DiamondKeySecurity/sensor_hw/PCA-000152-02.xls

Digital Design Corporation
Diamond Key Mezz Rev 2
PCA-000152-02
Nov 07 2018 10:00:46
DDC Part # | Quantity | Designator | Description | Value | Package | Supplier | Supplier Part # | MFG | MFG Part # | RoHS/WEEE
CAP-000013-00 | 1 | C5 | CAP CERM .047UF 10% 16V X5R 0402 Mfg. AVX Corporation | 0.047uF | 0402 | Avnet Electronics | 0402YD473KAT2A | AVX Corporation | 0402YD473KAT2A | Compliant 6 of 6
CAP-000169-00 | 8 | C1, C2, C3, C7, C8, C9, C10, C11 | .1uF, 25V, X5R, 0402, Mfg: Taiyo Yuden | 0.1uF | 0402 | Avnet Electronics | TMK105BJ104KV-F/BKN | Taiyo Yuden | TMK105BJ104KV-F | Compliant 6 of 6
CAP-000192-00 | 1 | C6 | .068uF, 16V, X5R, 0402 | .068uF | 0402 | Digi-Key Corporation | 445-4968-6-ND | TDK | C1005X5R1C683K | Compliant 6 of 6
CON-000108-00 | 1 | J3 | 2 PIN, 1 ROW, .1 INCH, Mfg: Samtec. | TSW-102 |  | Arrow Electronics (Advantage) | TSW-102-07-F-S | Samtec | TSW-102-07-F-S | Compliant 6 of 6
CON-000176-00 | 1 | J4 | CONN HEADER 2POS .100 R/A GOLD, Mfg: Molex | 70553-0001 |  | Digi-Key Corporation | WM4900-ND | Molex | 70553-0001 | Compliant 6 of 6
CON-000369-00 | 1 | REP_JP3 | CONN HEADER 6POS .100 STR TIN | 67996-406HLF | N/A | Digi-Key Corporation | 609-3218-ND | FCI | 67996-406HLF | Lead free / RoHS Com
CON-000533-00 | 1 | J2 | HOLDER BATT 1 CELL CR123A | CR123A |  | Digi-Key Corporation | 708-1412-ND | Bulgin | BX0123 | Lead free / RoHS Com
CON-000534-00 | 1 | JP5 | CONN RCPT 10POS .100 | 10_Pin |  | Digi-Key Corporation | 609-3550-ND | AmphenolFCI | 75915-310LF | Lead free / RoHS Com
CON-000536-00 | 2 | SV1, SV3 | CONN RCPT 16POS .100 2 Row | 8x2_Socket |  | Digi-Key Corporation | 609-3554-ND | AmphenolFCI | 87606-308LF | Lead free / RoHS Com
CON-000537-00 | 1 | JP3 | CONN RCPT .100 2x3 | 2x3_Socket |  | Digi-Key Corporation | SAM10016-ND | SamtecInc. | SSW-103-01-F-D | Lead free / RoHS Com
CON-000539-00 | 1 | J1 | CONN RCPT 6POS .100 TH | 6 Pin Socket |  | Digi-Key Corporation | 609-3558-ND | AmphenolFCI | 75915-306LF | Lead free / RoHS Com
CON-000540-00 | 1 | REP_J1 | CONN HEADER 6 POS 2.54 TH | 6 Pin Header |  | Digi-Key Corporation | 732-5319-ND | WurthElectronicsInc. | 61300611121 | Lead free / RoHS Com
CON-000545-00 | 1 | REP_JP5 | CONN HEADER 10POS .100 STR 30AU | 10 Pin Header |  | Digi-Key Corporation | 609-3250-ND | AmphenolFCI | 68000-110HLF | Lead free / RoHS Com
CON-000550-00 | 1 | J5 | Connector Header Through Hole, Right Angle 7 position 0.100" (2.54mm) | 705530006 | 7 pin | Digi-Key Corporation | WM4905-ND | Molex | 705530006 | Lead free / RoHS Com
DIO-000075-00 | 1 | PD1 | PHOTODIODE PIN 900NM 0805 | TEMD7000X01 | 0805 | Digi-Key Corporation | TEMD7000X01DKR-ND | VishaySemiconductorO | TEMD7000X01 | Lead free / RoHS Com
DIO-000077-00 | 1 | D4 | Diode Standard 30V 15A Surface Mount DDPAK/TO-263-3 26mV Vf | SM74611 | TO-263 | Digi-Key Corporation | 296-35688-1-ND | Texas Instruments | SM74611KTTR | Lead free / RoHS Com
ICT-000256-00 | 1 | U2 | PHOTOCOUPLER, TRANSISTOR OUT | PS2711 | SOP-4 | Digi-Key Corporation | PS2711-1-M-A-ND | NEC | PS2711-1-M-A | Compliant 6 of 6
ICT-000794-00 | 1 | U3 | ACCELEROMETER 2-8G SPI 16LGA | ADXL362 | 16-TFLGA | Digi-Key Corporation | ADXL362BCCZ-RLTR-ND | AnalogDevicesInc. | ADXL362BCCZ-RL | Lead free / RoHS Com
ICT-000795-00 | 1 | U4 | IC SUPERVISOR MPU 16SOIC | ADM696 | 16-SOIC | Digi-Key Corporation | ADM696ARZ-REELTR-ND | AnalogDevicesInc. | ADM696ARZ-REEL | Lead free / RoHS Com
ICT-000798-00 | 1 | U9 | IC OPTICAL PROXIMITY 24QFN | AmbLtSensor | QFN24 | Digi-Key Corporation | MLX75030RLQ-AAA-000-RETR-ND | MelexisTechnologiesN | MLX75030RLQ-AAA-000-RE | Lead free / RoHS Com
ICT-000799-00 | 1 | U5 | IC I/O EXPANDER SPI 16B 28SOIC | 16bitSPIExpander | 28-SOIC | Digi-Key Corporation | MCP23S17T-E/SOTR-ND | MicrochipTechnology | MCP23S17T-E/SO | Lead free / RoHS Com
ICT-000807-00 | 1 | U1 | SCHMITT TRIGGER PHOTOCOUPLER | H11L1S | 6 pin | Digi-Key Corporation | 1080-1201-1-ND | Everlight | H11L1S(TA) | Lead free / RoHS Com
LED-001001-00 | 3 | D1, D2, D3 | LED, Green, 0603, Mfg: Avago | HSMG-C190 | 0603 | Arrow Electronics (Advantage) | HSMG-C190**MULT1 | Avago | HSMG-C190 | Compliant 6 of 6
MOD-000049-00 | 1 | U6 | Isolated Module DC DC Converter 1 Output 3.3V 227mA 2.97V - 3.63V Input | CME0303S3C | 4 pin | Digi-Key Corporation | 811-2889-5-ND | Murata | CME0303S3C | Lead free / RoHS Com
PCB-000270-02 PCB | 1 | PCB1 | Diamond Key Mezz Rev 2 |  |  | PCB Universe | PCB-000270-02 | PCB Universe | PCB-000270-02
RES-000002-00 | 1 | R17 | 0 OHM 1/16W 5% 0402, Mfg: Panasonic | 0 | 0402 | Digi-Key Corporation | P0.0JCT-ND | Panasonic | ERJ-2GE0R00X | Compliant 6 of 6
RES-000004-00 | 4 | R4, R5, R6, R9 | 1K 0402 1% 1/10W, Mfg: Panasonic | 1K | 0402 | Avnet Electronics | ERJ-2RKF1001X/BKN | Panasonic | ERJ-2RKF1001X | Compliant 6 of 6
RES-000005-00 | 4 | R1, R7, R13, R14 | RES 4.75K OHM 1/10W 1% 0402 SMD, MFG: PANASONIC | 4.75K | 0402 | Avnet Electronics | ERJ-2RKF4751X/BKN | Panasonic | ERJ-2RKF4751X | Compliant 6 of 6
RES-000006-00 | 1 | R2 | 100 Ohms 0402 1% 1/10W, Mfg: Panasonic | 100 | 0402 | Avnet Electronics | ERJ-2RKF1000X | Panasonic | ERJ-2RKF1000X | Compliant 6 of 6
RES-000007-00 | 2 | R18, R19 | 10K 0402 1% 1/10W, Mfg: Panasonic | 10K | 0402 | Avnet Electronics | ERJ-2RKF1002X/BKN | Panasonic | ERJ-2RKF1002X | Compliant 6 of 6
RES-000014-00 | 1 | R3 | 75 0402 1% 1/10W Mfg. Panasonic | 75 | 0402 | Digi-Key Corporation | P75.0LDKR-ND | Panasonic | ERJ-2RKF75R0X | Compliant 6 of 6
RES-000021-00 | 3 | R8, R10, R12 | RES 100K OHM 1/10W 1% 0402 SMD Mfg. Panasonic | 100K | 0402 | Avnet Electronics | ERJ-2RKF1003X | Panasonic | ERJ-2RKF1003X | Compliant 6 of 6
RES-000124-00 | 1 | R11 | 1.5K 0402 1% 1/16W | 1.5K | 0402 | Digi-Key Corporation | P1.50KLTR-ND | Panasonic | ERJ-2RKF1501X | Compliant 6 of 6
RES-000437-00 | 1 | R15 | 56.2K 0402 1% 1/16W | 56.2K | 0402 | Digi-Key Corporation | P56.2KLDKR-ND | Panasonic | ERJ-2RKF5622X | Compliant 6 of 6
RLY-000003-00 | 2 | RLY1, RLY2 | RELAY 2 COIL LATCHING DPDT 1A 3V | 2 Coil |  | Digi-Key Corporation | 255-2347-2-ND | PanasonicElectricWor | TXS2SA-L2-3V-Z | Lead free / RoHS Com
XSR-000057-00 | 5 | Q1, Q2, Q3, Q4, Q5 | TRANS PREBIAS 470/10k NPN 200MW SOT23-3 | 470/10k | SOT-23 | Arrow Electronics (Advantage) | DDTD142JC-7-F**MULT1 | DiodesIncorporated | DDTD142JC-7-F | Lead free / RoHS Com
