DiamondKeySecurity/sensor_hw/Sensor.ods

Cryptech Sensor Board
> All the information Screaming Circuits needs in a Bill of Materials to complete an order is in columns B through G.
> Distributor part numbers (ie.. DigiKey Part #'s) are not required for Kitted orders, but are helpful for Turn-Key pricing.
> The BOM is the primary file that Screaming Circuits goes by whenever there is any conflicting information.
> There is information in the far right column that helps to get an assembly quote. Look at the bottom to see a board summary.
> Highlight in RED any Do Not Stuff parts ("DNS") , and they will be excluded from the build. Parts not listed on the BOM are considered DNS.
Item # | Qty | Ref Des | Manufacturer | Mfg Part # | Dist. Part # | Description | Package | Type
1 | 1 | C5 | AVX Corporation | 0402YD473KAT2A |  | CAP CERM .047UF 10% 16V X5R 0402 | 402 | smt | 0
2 | 8 | C1, C2, C3, C7, C8, C9, C10, C11 | Taiyo Yuden | TMK105BJ104KV-F |  | .1uF, 25V, X5R, 0402, Mfg: Taiyo Yuden | 402 |  | 0
3 | 1 | C6 | TDK | C1005X5R1C683K |  | .068uF, 16V, X5R, 0402 | 402 |  | 0
4 | 1 | J3 | Samtec | TSW-102-07-F-S |  | 2 PIN, 1 ROW, .1 INCH, Mfg: Samtec. |  | thru | 1 | 2
5 | 1 | J4 | Molex | 70553-0001 |  | CONN HEADER 2POS .100 R/A GOLD, Mfg: Molex |  | thru | 1 | 2
6 | 1 | REP_JP3 | FCI | 67996-406HLF |  | CONN HEADER 6POS .100 STR TIN | N/A | thru | 1 | 6
7 | 1 | J2 | Bulgin | BX0123 |  | HOLDER BATT 1 CELL CR123A |  | thru | 1 | 2
8 | 1 | JP5 | AmphenolFCI | 75915-310LF |  | CONN RCPT 10POS .100 |  | thru | 1 | 10
9 | 2 | SV1, SV3 | AmphenolFCI | 87606-308LF |  | CONN RCPT 16POS .100 2 Row |  | thru | 2 | 32
10 | 1 | JP3 | SamtecInc. | SSW-103-01-F-D |  | CONN RCPT .100 2x3 |  | thru | 1 | 6
11 | 1 | J1 | AmphenolFCI | 75915-306LF |  | CONN RCPT 6POS .100 TH |  | thru | 1 | 6
12 | 1 | REP_J1 | WurthElectronicsInc. |  |  | CONN HEADER 6 POS 2.54 TH |  | thru | 1 | 6
13 | 1 | REP_JP5 | AmphenolFCI | 68000-110HLF |  | CONN HEADER 10POS .100 STR 30AU |  | thru | 1 | 10
14 | 1 | J5 | Molex |  |  | Connector Header Thru Hole, Right Angle 7 position 0.100" (2.54mm) | 7 pin | thru | 1 | 7
15 | 1 | PD1 | VishaySemiconductorO | TEMD7000X01 |  | PHOTODIODE PIN 900NM 0805 | 805 | smt | 0
16 | 1 | D4 | Texas Instruments | SM74611KTTR |  | Diode Standard 30V 15A Surface Mount DDPAK/TO-263-3 26mV Vf | TO-263 | smt | 0
17 | 1 | U2 | NEC | PS2711-1-M-A |  | PHOTOCOUPLER, TRANSISTOR OUT | SOP-4 | smt | 0
18 | 1 | U3 | AnalogDevicesInc. | ADXL362BCCZ-RL |  | ACCELEROMETER 2-8G SPI 16LGA | 16-TFLGA |  | 0
19 | 1 | U4 | AnalogDevicesInc. | ADM696ARZ-REEL |  | IC SUPERVISOR MPU 16SOIC | 16-SOIC |  | 0
20 | 1 | U9 | MelexisTechnologiesN | MLX75030RLQ-AAA-000-RE |  | IC OPTICAL PROXIMITY 24QFN | QFN24 |  | 0
21 | 1 | U5 | MicrochipTechnology | MCP23S17T-E/SO |  | IC I/O EXPANDER SPI 16B 28SOIC | 28-SOIC |  | 0
22 | 1 | U1 | Everlight | H11L1S(TA) |  | SCHMITT TRIGGER PHOTOCOUPLER | 6 pin |  | 0
23 | 3 | D1, D2, D3 | Avago | HSMG-C190 |  | LED, Green, 0603, Mfg: Avago | 603 |  | 0
24 | 1 | U6 | Murata | CME0303S3C |  | Isolated Module DC DC Converter 1 Output 3.3V 227mA 2.97V - 3.63V Input | 4 pin | thru | 1 | 4
25 | 1 | PCB1 | PCB Universe | PCB-000270-02 |  | Diamond Key Mezz Rev 2 |  |  | 0
26 | 1 | R17 | Panasonic | ERJ-2GE0R00X |  | 0 OHM 1/16W 5% 0402, Mfg: Panasonic | 402 |  | 0
27 | 4 | R4, R5, R6, R9 | Panasonic | ERJ-2RKF1001X |  | 1K 0402 1% 1/10W, Mfg: Panasonic | 402 |  | 0
28 | 4 | R1, R7, R13, R14 | Panasonic | ERJ-2RKF4751X |  | RES 4.75K OHM 1/10W 1% 0402 SSMD | 402 |  | 0
29 | 1 | R2 | Panasonic | ERJ-2RKF1000X |  | 100 Ohms 0402 1% 1/10W, Mfg: Panasonic | 402 |  | 0
30 | 2 | R18, R19 | Panasonic | ERJ-2RKF1002X |  | 10K 0402 1% 1/10W, Mfg: Panasonic | 402 |  | 0
31 | 1 | R3 | Panasonic | ERJ-2RKF75R0X |  | 75 0402 1% 1/10W Mfg. Panasonic | 402 |  | 0
32 | 3 | R8, R10, R12 | Panasonic | ERJ-2RKF1003X |  | RES 100K OHM 1/10W 1% 0402 SMD Mfg. Panasonic | 402 |  | 0
33 | 1 | R11 | Panasonic | ERJ-2RKF1501X |  | 1.5K 0402 1% 1/16W | 402 |  | 0
34 | 1 | R15 | Panasonic | ERJ-2RKF5622X |  | 56.2K 0402 1% 1/16W | 402 |  | 0
35 | 2 | RLY1, RLY2 | PanasonicElectricWor | TXS2SA-L2-3V-Z |  | RELAY 2 COIL LATCHING DPDT 1A 3V |  | thru | 2 | 8
36 | 5 | Q1, Q2, Q3, Q4, Q5 | DiodesIncorporated | DDTD142JC-7-F |  | TRANS PREBIAS 470/10k NPN 200MW SOT23-3 | SOT-23 |  | 0
 | 60 |  |  |  |  |  |  |  | 15 | 101
 |  |  |  |  |  | BOARD SUMMARY FOR QUOTE
 |  |  |  |  |  | Unique Part Count | 36
 |  |  |  |  |  | Total Placements | 60
 |  |  |  |  |  | Thru Hole Placements | 15
 |  |  |  |  |  | Has BGA Placements? | No
