DiamondKeySecurity/sensor_hw/PCA-000152-01_Assembly.PDF

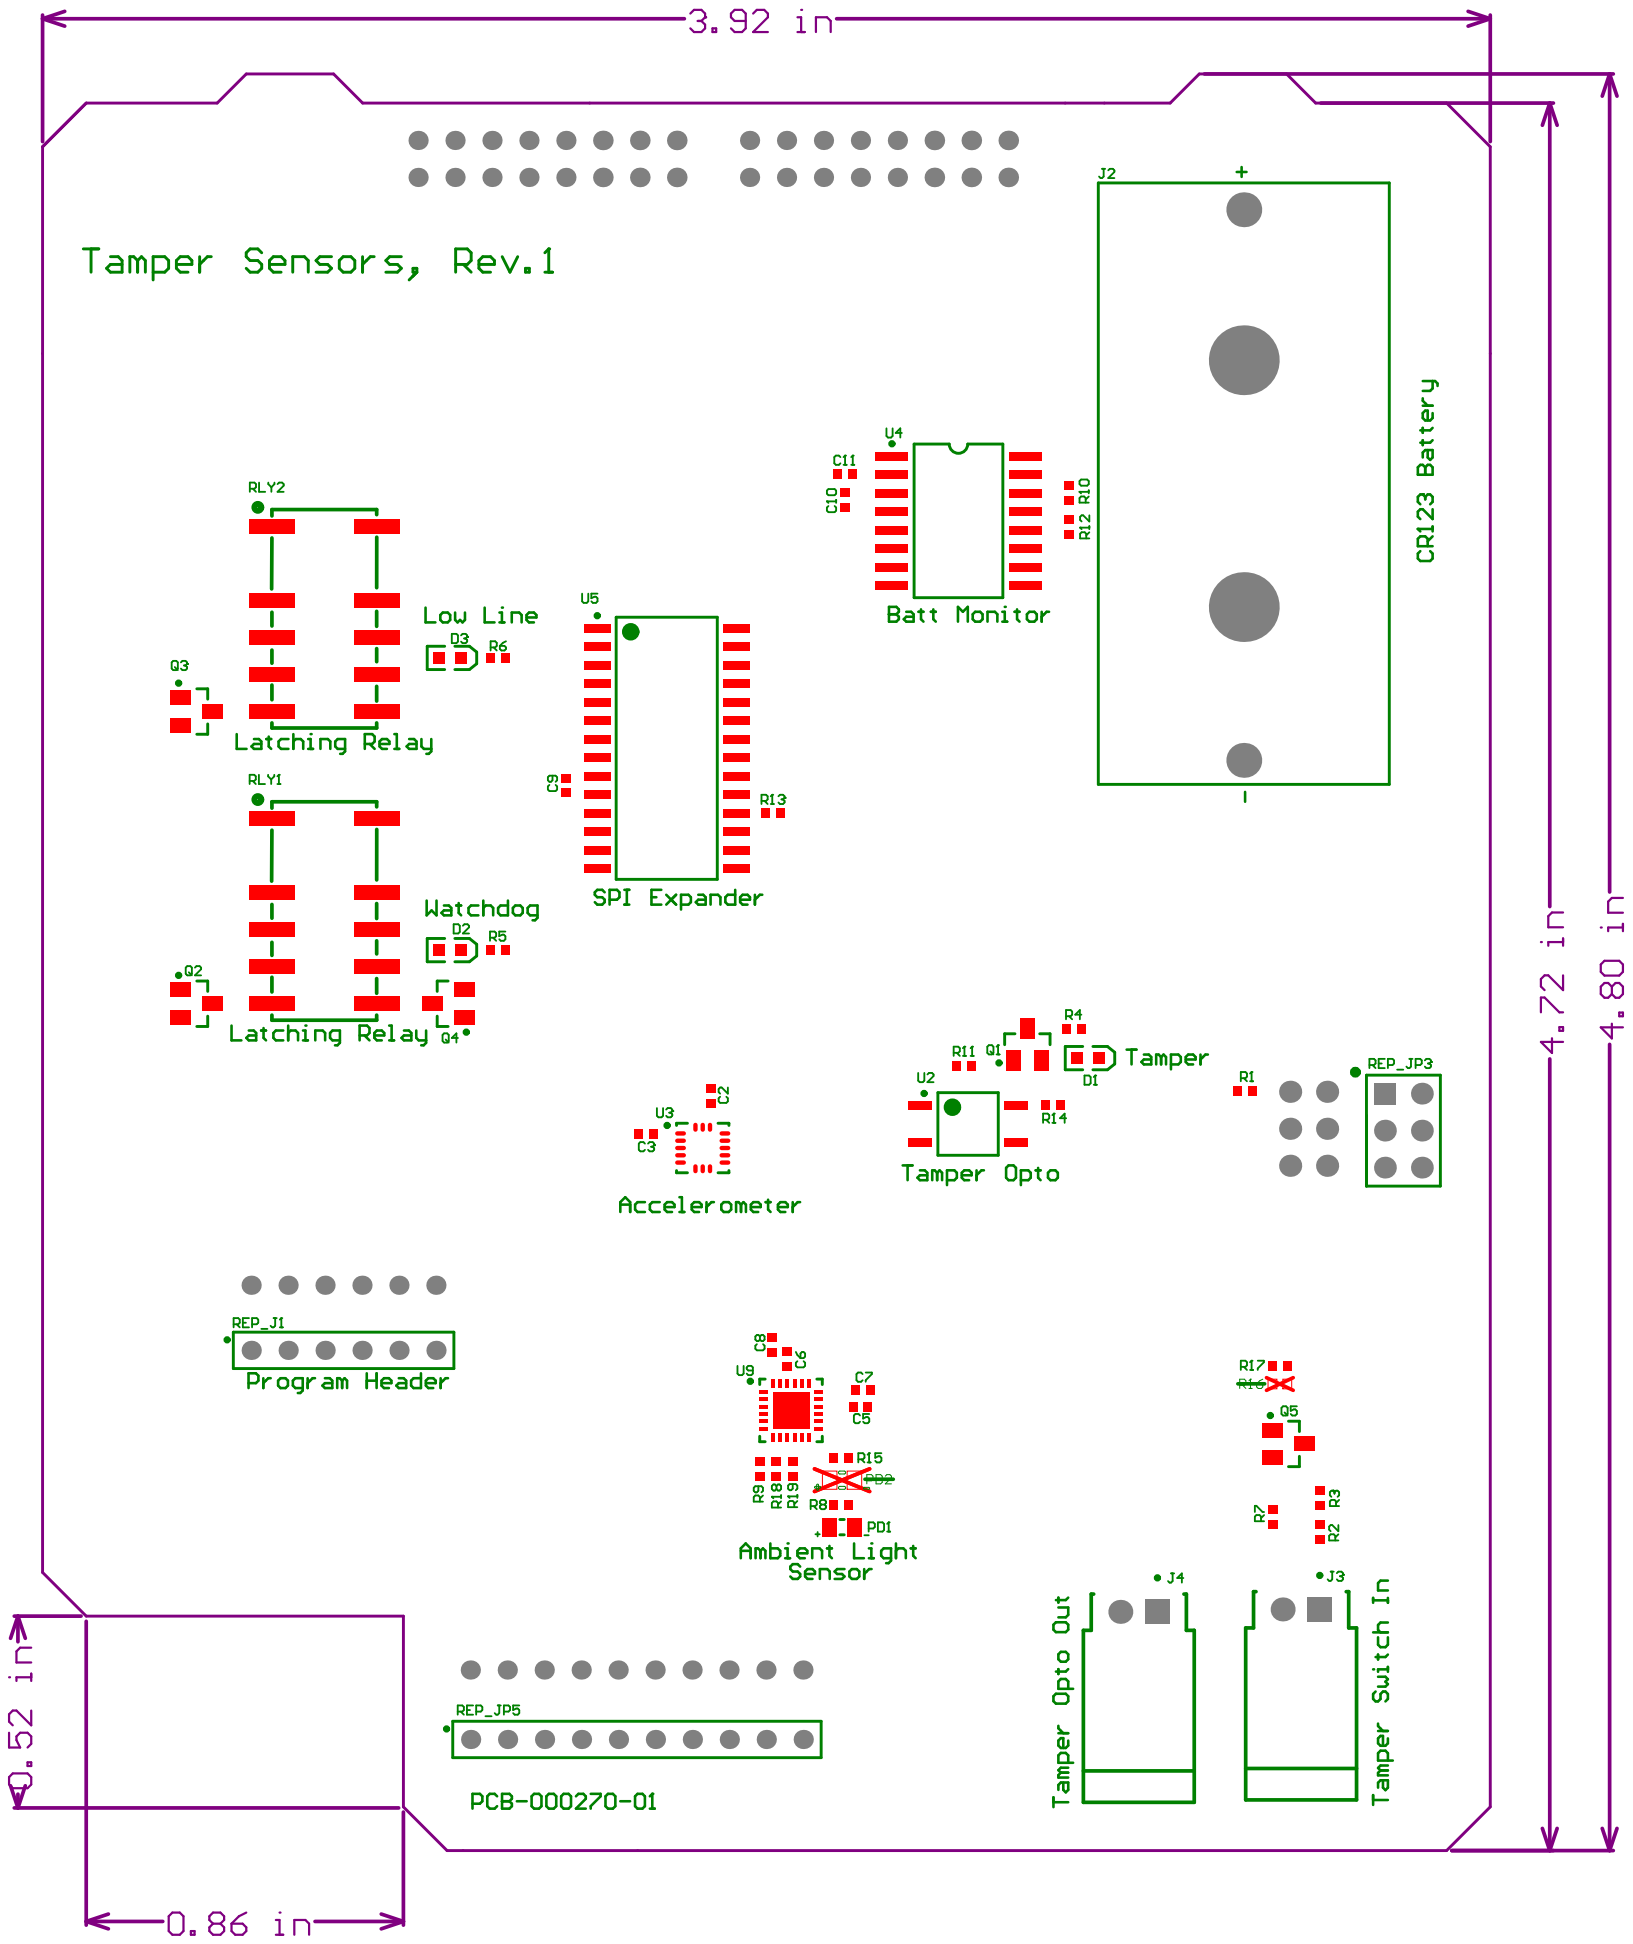
[picture p3: page 1]

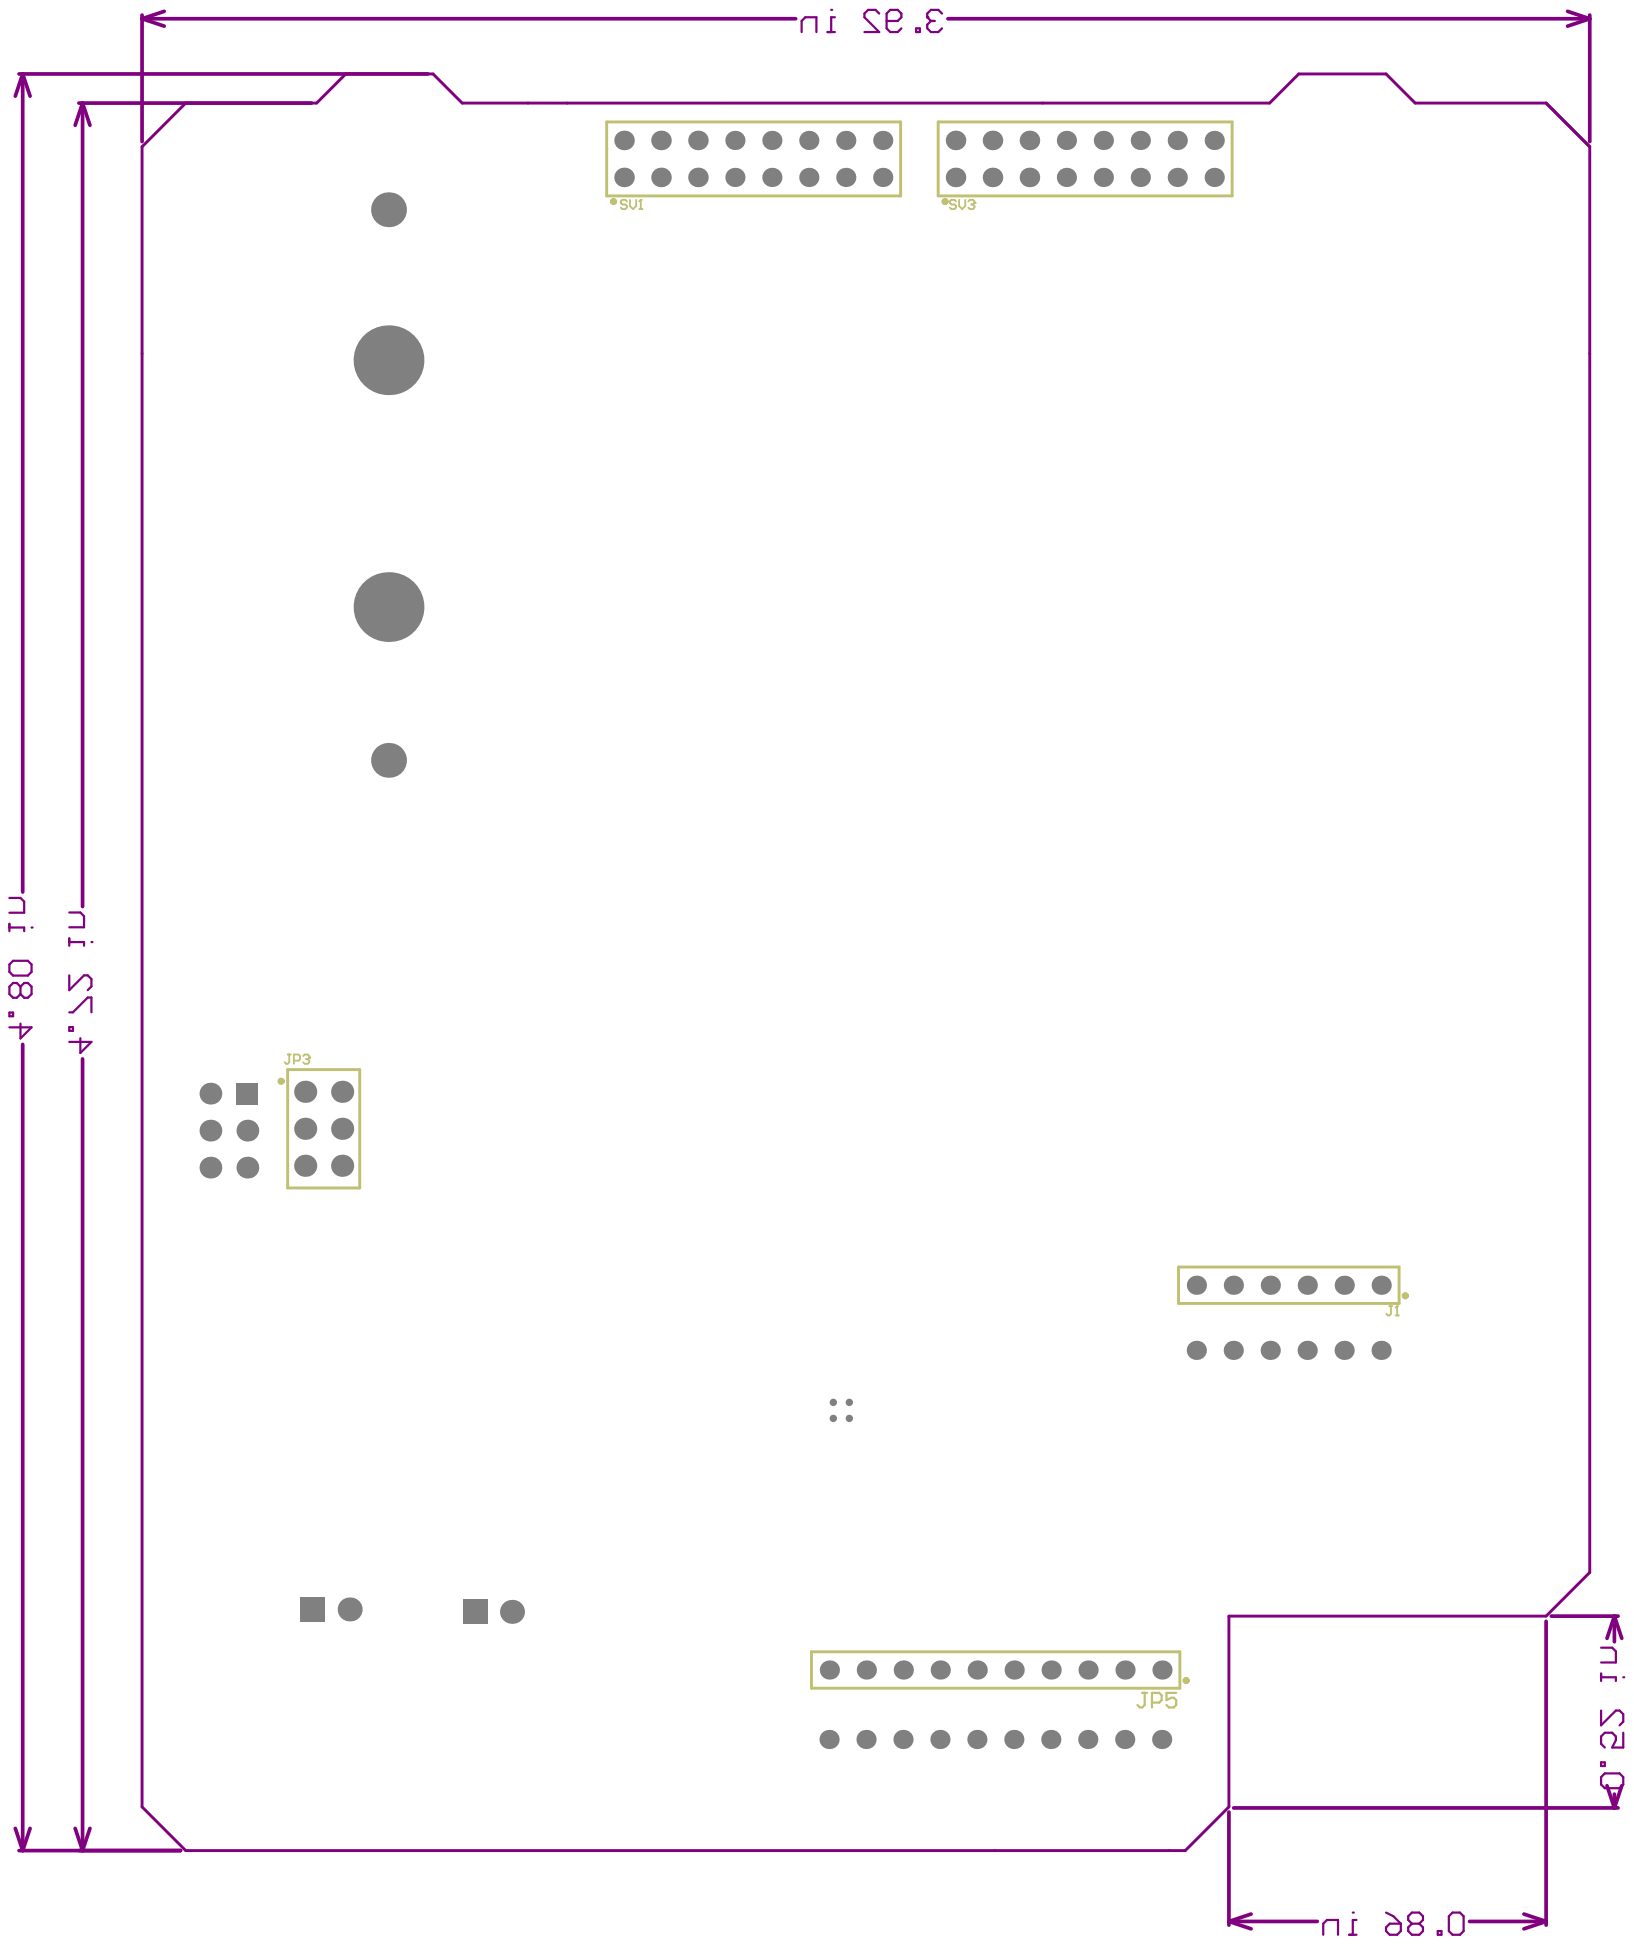
[picture p4: page 2]
