DiamondKeySecurity/sensor_hw/(list of files, drawings)

Other design files:
DKey_Mezz_Rev2.PCB
